Ultrawipf/floppymusicctrl/hardware/BOM_controller.xlsx

Comment | Designator | Footprint | LCSC
Red | LED2, LED3 | "0805" | C84256
 | GND, V+ | 1X01
1X05 Pinheader | SWD | 1X05
2x17 angled female header | FDD | 2X17/90 | C2897437
1.5k | R1, R2, R3 | R0603
100nF | C3, C4 | C0603
3.3V LDO | U2 | SOT89-R | C14289
4.7uF | C1, C2 | C0603
2x8 angled header | ADRIN, ADROUT | 2X08/90 | C9142
STM32G030F6P6 | U1 | TSSOP20 | C529330
Green | LED1 | "0805" | C2297
4.7k | R4,R5 | R0603
