Ultrawipf/floppymusicctrl/hardware/floppycontrol_mcu.pdf

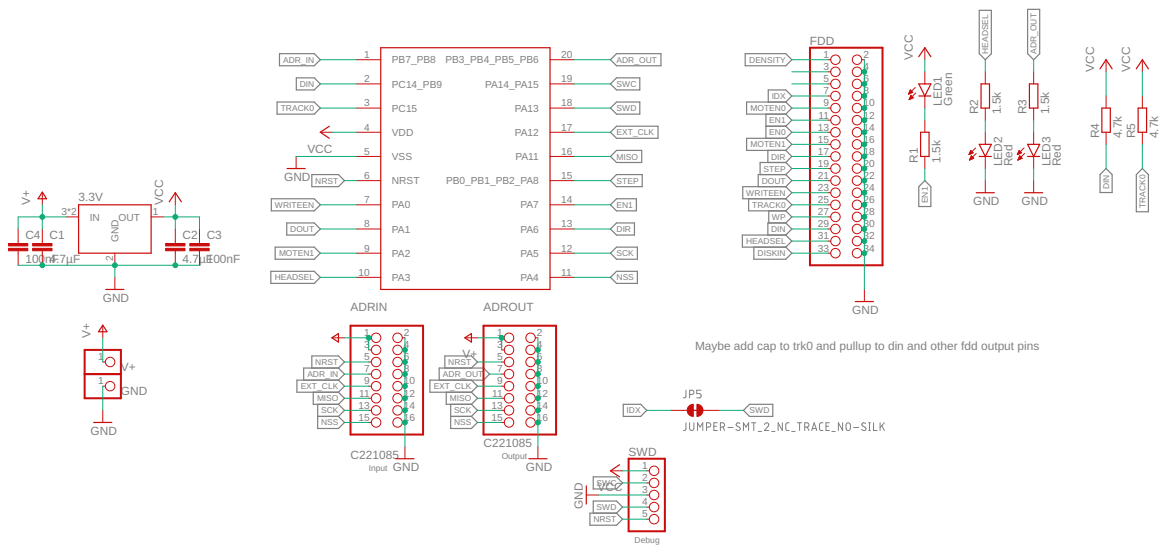
[picture p1: page 1]

Maybe add cap to trk0 and pullup to din and other fdd output pins
