Ultrawipf/floppymusicctrl/hardware/ffboard_adapter.brd

## EAGLE design hardware/ffboard_adapter.brd (2023-07-14)

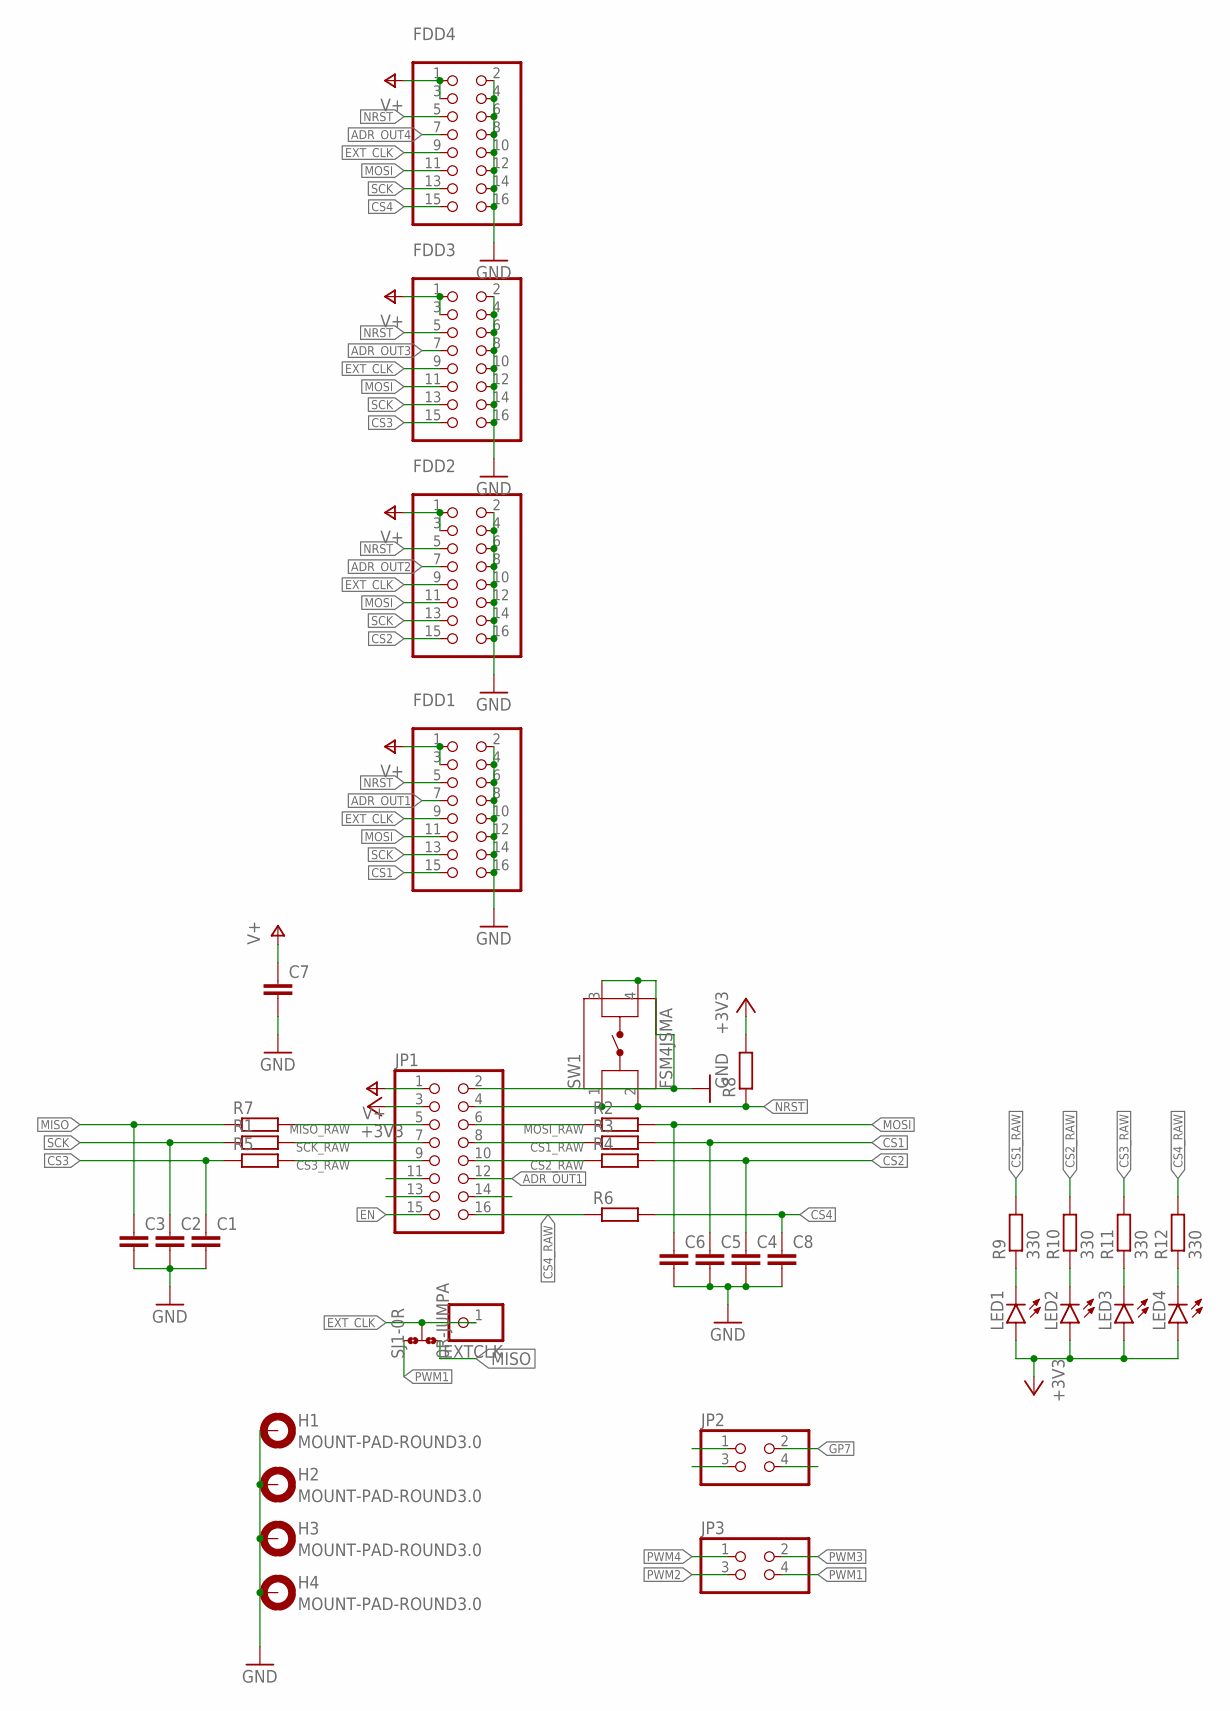
[picture p2: schematic ffboard_adapter.sch]

Parts:
C1, C2, C3, C4, C5, C6, C7, C8: C-EUC0603; C0603
EXTCLK: PINHD-1X1; 1X01
FDD1, FDD2, FDD3, FDD4: C221085; 2X08
H1, H2, H3, H4: MOUNT-PAD-ROUND3.0; 3,0-PAD
JP1: PINHD-2X8; 2X08
JP2, JP3: PINHD-2X2; 2X02
LED1, LED2, LED3, LED4: LEDSML0805; SML0805
R1, R2, R3, R4, R5, R6, R7, R8: R-EU_R0603; R0603
R9, R10, R11, R12: 330; R0603
SJ1: 0R-JUMPA; A0R-JMP
SW1: FSM4JSMA

Connections:
+3V3: JP1.3, LED1.A, LED2.A, LED3.A, LED4.A, R8.2
ADR_OUT1: FDD1.7, JP1.12
ADR_OUT2: FDD2.7
ADR_OUT3: FDD3.7
ADR_OUT4: FDD4.7
CS1: C5.1, FDD1.15, R3.2
CS1_RAW: JP1.8, R3.1, R9.2
CS2: C4.1, FDD2.15, R4.2
CS2_RAW: JP1.10, R4.1, R10.2
CS3: C1.1, FDD3.15, R5.1
CS3_RAW: JP1.9, R5.2, R11.2
CS4: C8.1, FDD4.15, R6.2
CS4_RAW: JP1.16, R6.1, R12.2
EN: JP1.15
EXT_CLK: EXTCLK.1, FDD1.9, FDD2.9, FDD3.9, FDD4.9, SJ1.2
GND: C1.2, C2.2, C3.2, C4.2, C5.2, C6.2, C7.2, C8.2, FDD1.2, FDD1.4, FDD1.6, FDD1.8, FDD1.10, FDD1.12, FDD1.14, FDD1.16, FDD2.2, FDD2.4, FDD2.6, FDD2.8, FDD2.10, FDD2.12, FDD2.14, FDD2.16, FDD3.2, FDD3.4, FDD3.6, FDD3.8, FDD3.10, FDD3.12, FDD3.14, FDD3.16, FDD4.2, FDD4.4, FDD4.6, FDD4.8, FDD4.10, FDD4.12, FDD4.14, FDD4.16, H1.B3,0, H2.B3,0, H3.B3,0, H4.B3,0, JP1.2, SW1.3, SW1.4
GP7: JP2.2
MISO: C3.1, R7.1, SJ1.3
MISO_RAW: JP1.5, R7.2
MOSI: C6.1, FDD1.11, FDD2.11, FDD3.11, FDD4.11, R2.2
MOSI_RAW: JP1.6, R2.1
unnamed: LED1.C, R9.1
unnamed: LED2.C, R10.1
unnamed: LED3.C, R11.1
unnamed: LED4.C, R12.1
NRST: FDD1.5, FDD2.5, FDD3.5, FDD4.5, JP1.4, R8.1, SW1.1, SW1.2
PWM1: JP3.4, SJ1.1
PWM2: JP3.3
PWM3: JP3.2
PWM4: JP3.1
SCK: C2.1, FDD1.13, FDD2.13, FDD3.13, FDD4.13, R1.1
SCK_RAW: JP1.7, R1.2
V+: C7.1, FDD1.1, FDD1.3, FDD2.1, FDD2.3, FDD3.1, FDD3.3, FDD4.1, FDD4.3, JP1.1

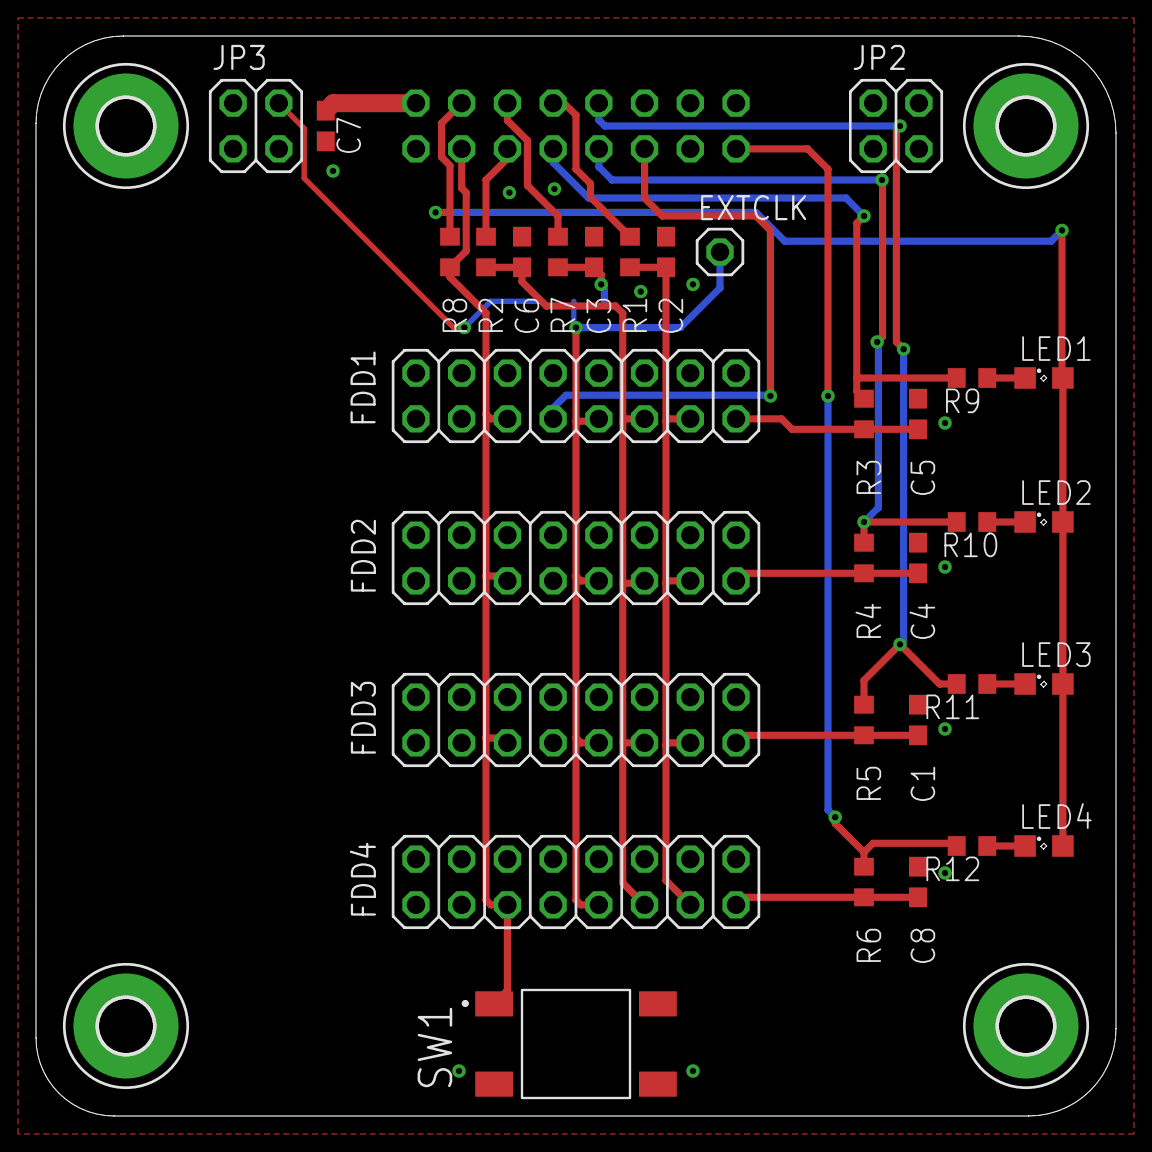
[picture p3: board ffboard_adapter.brd from above]

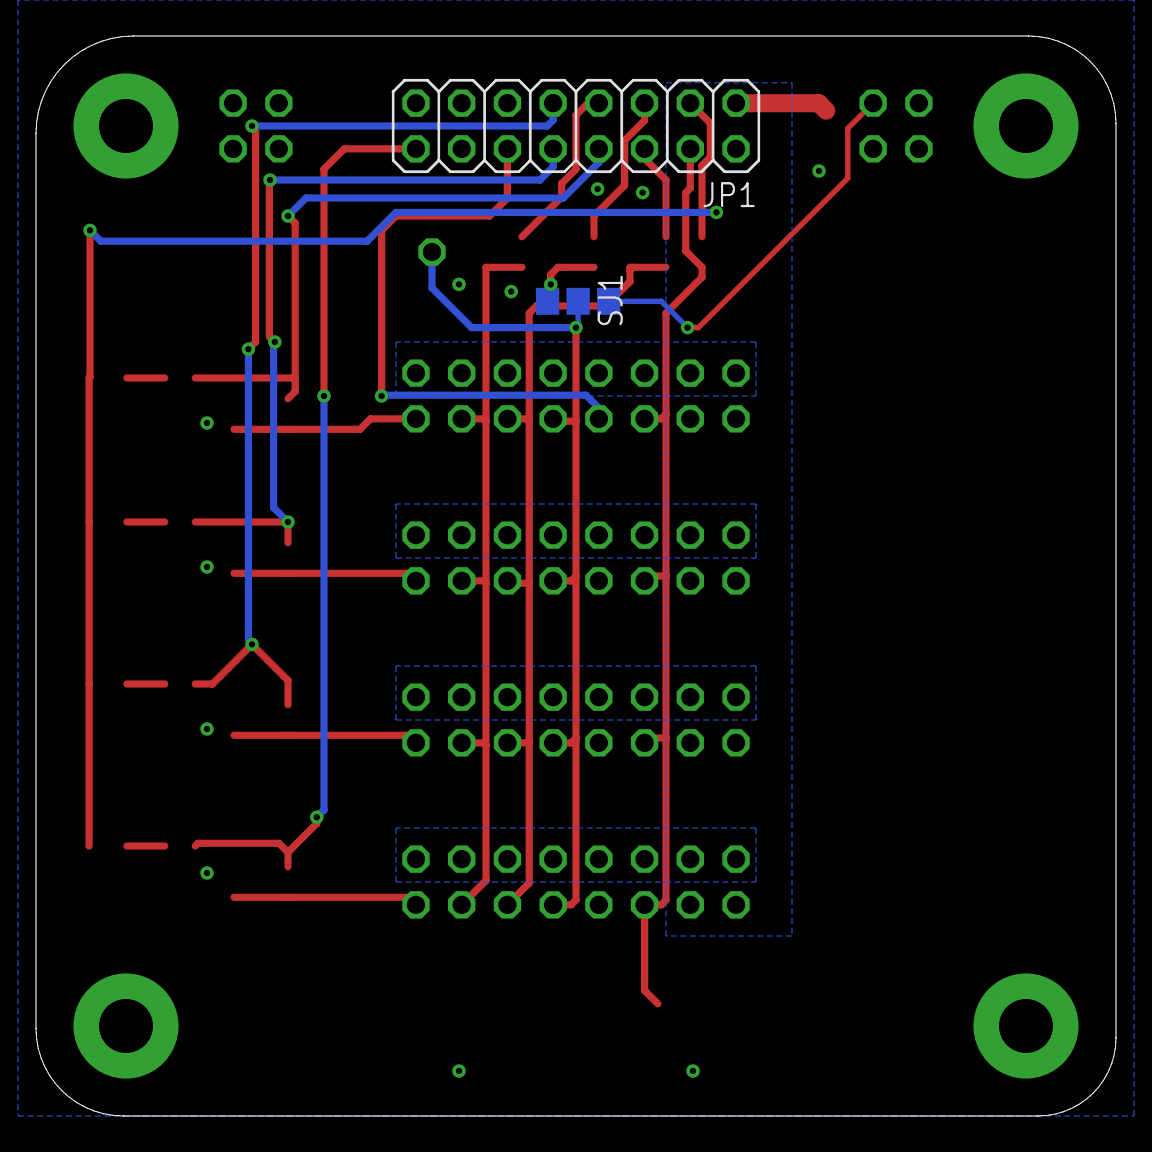
[picture p4: board ffboard_adapter.brd from below]

Board: 2 copper layers, 60.0 x 60.0 mm, 38 parts (2 on the bottom side), 25 nets.
