Ultrawipf/floppymusicctrl/hardware/floppycontrol_mcu.brd

## EAGLE design hardware/floppycontrol_mcu.brd (2023-07-14)

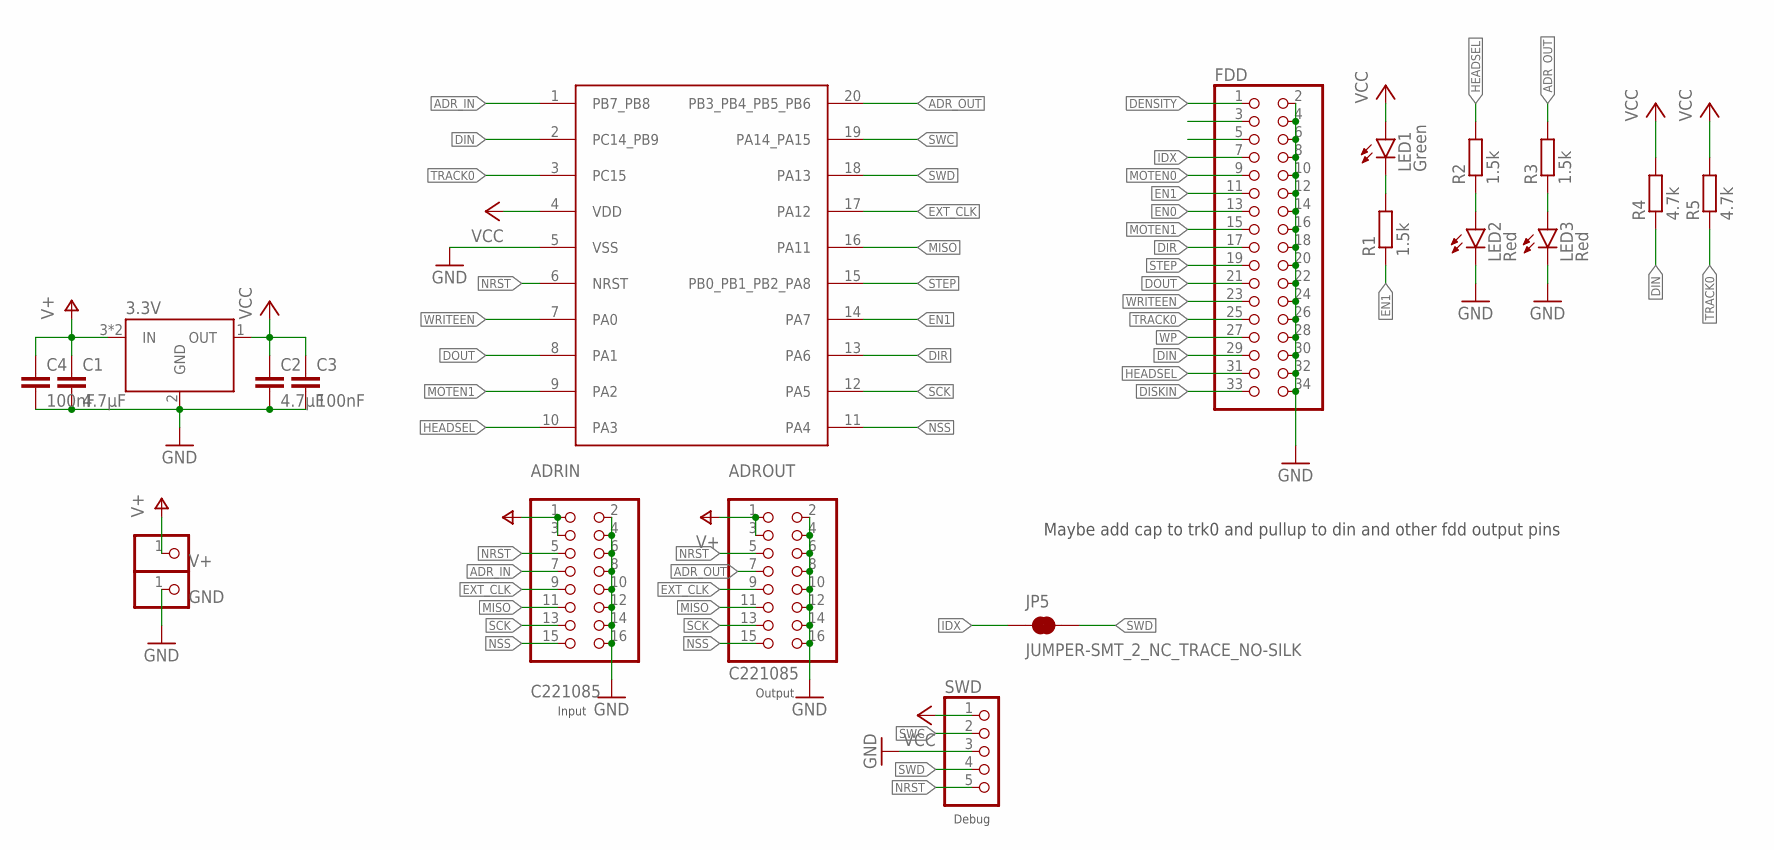
[picture p5: schematic floppycontrol_mcu.sch]

Parts:
ADRIN: C221085; 2X08/90
ADROUT: C221085; 2X08/90
C1, C2: 4.7µF; C0603
C3, C4: 100nF; C0603
FDD: PINHD-2X17/90; 2X17/90
GND: PINHD-1X1; 1X01
JP5: JUMPER-SMT_2_NC_TRACE_NO-SILK; SMT-JUMPER_2_NC_TRACE_NO-SILK
LED1: Green; CHIP-LED0805
LED2, LED3: Red; CHIP-LED0805
R1, R2, R3: 1.5k; R0603
R4, R5: 4.7k; R0603
SWD: PINHD-1X5; 1X05
U1: STM32G030F6P6TSSOP20; TSSOP20
U2: 3.3V; SOT89-R
V+: PINHD-1X1; 1X01

Connections:
ADR_IN: ADRIN.7, U1.1 (PB7_PB8)
ADR_OUT: ADROUT.7, R3.2, U1.20 (PB3_PB4_PB5_PB6)
DENSITY: FDD.1
DIN: FDD.29, R4.1, U1.2 (PC14_PB9)
DIR: FDD.17, U1.13 (PA6)
DISKIN: FDD.33
DOUT: FDD.21, U1.8 (PA1)
EN0: FDD.13
EN1: FDD.11, R1.1, U1.14 (PA7)
EXT_CLK: ADRIN.9, ADROUT.9, U1.17 (PA12)
GND: ADRIN.2, ADRIN.4, ADRIN.6, ADRIN.8, ADRIN.10, ADRIN.12, ADRIN.14, ADRIN.16, ADROUT.2, ADROUT.4, ADROUT.6, ADROUT.8, ADROUT.10, ADROUT.12, ADROUT.14, ADROUT.16, C1.2, C2.2, C3.2, C4.2, FDD.2, FDD.4, FDD.6, FDD.8, FDD.10, FDD.12, FDD.14, FDD.16, FDD.18, FDD.20, FDD.22, FDD.24, FDD.26, FDD.28, FDD.30, FDD.32, FDD.34, GND.1, LED2.C, LED3.C, SWD.3, U1.5 (VSS), U2.2 (GND)
HEADSEL: FDD.31, R2.2, U1.10 (PA3)
IDX: FDD.7, JP5.1
MISO: ADRIN.11, ADROUT.11, U1.16 (PA11)
MOTEN0: FDD.9
MOTEN1: FDD.15, U1.9 (PA2)
unnamed: LED1.C, R1.2
unnamed: LED2.A, R2.1
unnamed: LED3.A, R3.1
NRST: ADRIN.5, ADROUT.5, SWD.5, U1.6 (NRST)
NSS: ADRIN.15, ADROUT.15, U1.11 (PA4)
SCK: ADRIN.13, ADROUT.13, U1.12 (PA5)
STEP: FDD.19, U1.15 (PB0_PB1_PB2_PA8)
SWC: SWD.2, U1.19 (PA14_PA15)
SWD: JP5.2, SWD.4, U1.18 (PA13)
TRACK0: FDD.25, R5.1, U1.3 (PC15)
V+: ADRIN.1, ADRIN.3, ADROUT.1, ADROUT.3, C1.1, C4.1, U2.3 (IN), U2.4 (IN), V+.1
VCC: C2.1, C3.1, LED1.A, R4.2, R5.2, SWD.1, U1.4 (VDD), U2.1 (OUT)
WP: FDD.27
WRITEEN: FDD.23, U1.7 (PA0)

Notes on the sheet:
Input
Output
Debug
Maybe add cap to trk0 and pullup to din and other fdd output pins

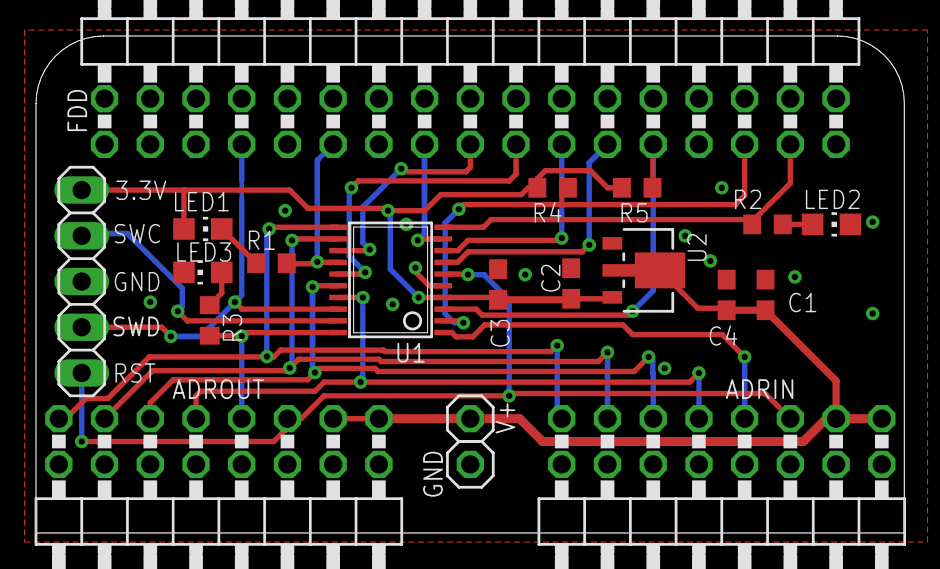
[picture p6: board floppycontrol_mcu.brd from above]

Board: 2 copper layers, 48.2 x 27.6 mm, 21 parts (1 on the bottom side), 25 nets.
