Ultrawipf/floppymusicctrl/Core/Src/main.c

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
/* Includes ------------------------------------------------------------------*/
#include "main.h"

/* USER CODE BEGIN Includes */
#include "floppyctrl.h"
/* USER CODE END Includes */

 SPI_HandleTypeDef hspi1;
DMA_HandleTypeDef hdma_spi1_rx;
DMA_HandleTypeDef hdma_spi1_tx;

TIM_HandleTypeDef htim1;
TIM_HandleTypeDef htim3;
TIM_HandleTypeDef htim14;
TIM_HandleTypeDef htim17;
DMA_HandleTypeDef hdma_tim17_ch1;

DMA_HandleTypeDef hdma_memtomem_dma1_channel4;
void SystemClock_Config(void);
static void MX_GPIO_Init(void);
static void MX_DMA_Init(void);
static void MX_SPI1_Init(void);
static void MX_TIM14_Init(void);
static void MX_TIM17_Init(void);
/**
  * @brief  The application entry point.
  * @retval int
  */
int main(void)
{
  /* MCU Configuration--------------------------------------------------------*/

  /* Reset of all peripherals, Initializes the Flash interface and the Systick. */
  HAL_Init();

  /* Configure the system clock */
  SystemClock_Config();

  /* USER CODE BEGIN SysInit */
  HAL_Delay(1000); // Allow some time for the debugger
  /* USER CODE END SysInit */

  /* Initialize all configured peripherals */
  MX_GPIO_Init();
  MX_DMA_Init();
  MX_SPI1_Init();
  MX_TIM1_Init();
  MX_TIM3_Init();
  MX_TIM14_Init();
  MX_TIM17_Init();
  /* USER CODE BEGIN 2 */
  // Set DIN pin to pullup
//  GPIO_InitTypeDef GPIO_InitStruct = {0};
//  GPIO_InitStruct.Pin = FDD_DIN_Pin;
//  GPIO_InitStruct.Mode = GPIO_MODE_AF_PP;
//  GPIO_InitStruct.Pull = GPIO_PULLUP;
//  GPIO_InitStruct.Speed = GPIO_SPEED_FREQ_HIGH;
//  HAL_GPIO_Init(FDD_DIN_GPIO_Port, &GPIO_InitStruct);

  // TODO use PA12 as ETR for tim1
  initializeTimers();
  findAddress();
  initializeComms();
  homeHeads();
  /* USER CODE END 2 */

  /* Infinite loop */
  /* USER CODE BEGIN WHILE */
  while (1)
  {
    /* USER CODE END WHILE */

    /* USER CODE BEGIN 3 */
	  update();

  }
  /* USER CODE END 3 */
}

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
