Ultrawipf/floppymusicctrl/Core/Inc/main.h

#define ADR_IN_Pin GPIO_PIN_7
#define ADR_IN_GPIO_Port GPIOB
#define ADR_IN_EXTI_IRQn EXTI4_15_IRQn
#define FDD_DIN_Pin GPIO_PIN_9
#define FDD_DIN_GPIO_Port GPIOB
#define FDD_TRK0_Pin GPIO_PIN_15
#define FDD_TRK0_GPIO_Port GPIOC
#define FDD_TRK0_EXTI_IRQn EXTI4_15_IRQn
#define FDD_WEN_Pin GPIO_PIN_0
#define FDD_WEN_GPIO_Port GPIOA
#define FDD_DOUT_Pin GPIO_PIN_1
#define FDD_DOUT_GPIO_Port GPIOA
#define FDD_MOT_Pin GPIO_PIN_2
#define FDD_MOT_GPIO_Port GPIOA
#define FDD_HEAD_Pin GPIO_PIN_3
#define FDD_HEAD_GPIO_Port GPIOA
#define FDD_DIR_Pin GPIO_PIN_6
#define FDD_DIR_GPIO_Port GPIOA
#define ENABLE_Pin GPIO_PIN_7
#define ENABLE_GPIO_Port GPIOA
#define FDD_STEP_Pin GPIO_PIN_8
#define FDD_STEP_GPIO_Port GPIOA
#define EXTCLK_Pin GPIO_PIN_12
#define EXTCLK_GPIO_Port GPIOA
#define SWD_IDX_Pin GPIO_PIN_13
#define SWD_IDX_GPIO_Port GPIOA
#define ADR_OUT_Pin GPIO_PIN_6
#define ADR_OUT_GPIO_Port GPIOB
