Ultrawipf/floppymusicctrl/Core/Inc/helpers.h

/*
 * helpers.h
 *
 *  Created on: 11.12.2022
 *      Author: Yannick
 */

#ifndef INC_HELPERS_H_
#define INC_HELPERS_H_
#include "main.h"

float bytesToFloat(uint8_t *bytes, uint8_t big_endian);

#endif /* INC_HELPERS_H_ */
